niuyuling/Blueberry/HW/blueberry/BOM.xlsx

Device 设备名 | Name 名称 | Manufacturer Part 生产商编号 | Designator 标号 | Value 值 | Footprint 丝印 | Supplier Part (LCSC) 商城编号 | Quantity 数量 | 备注 Note | 确认
Allwinner_H616 | Allwinner H616 | Allwinner H616 | U5 | Allwinner H616 | BGA284P65B1200_1400H125 | N/A | 1 | Allwinner H616 | yes
H5TQ4G63EFR-RDC | DDR3/DDR3L DRAM | H5TQ4G63EFR-RDC | U2 | DDR3/DDR3L DRAM | FBGA96 | N/A | 1 | 可选择单 Rank 或双 Rank 的 DDR3、DDR3L 内存颗粒 | yes
AXP1530 | AXP313A | AXP313A | U1 | AXP313A | WQFN-20_L3.0-W3.0-P0.40-BL-EP | N/A | 1 | H616 的 配套PMIC | yes
B-2100S40P-B110 | B-2100S40P-B110 | B-2100S40P-B110 | H1 | B-2100S40P-B110 | HDR-TH_40P-P2.54-V-M-R2-C20-S2.54 | N/A | 1 | 40 Pin Raspberry Pi Connector，默认不焊接 | yes
EMMC BGA153 | THGBMJG7C1LBAIL | EMMC04G-M627-A01 | U4 | THGBMJG7C1LBAIL | FBGA-153_L13.0-W11.5 | C879825 | 1 | BGA153 eMMC, Up to 128GB | yes
RClamp0524PATCT | RClamp0524PATCT | RClamp0524PATCT | D19,D21 | RClamp0524PATCT | SLP2510P8_L2.5-W1.0-P0.50-BL | C40960 | 2 | ESD组件，测试可不贴 | yes
MLP2016S1R0MT0S1 | 1239AS-H-1R0M=P2 | 1239AS-H-1R0M=P2 | L1,L2,L3 | 1uH | IND-SMD_L2.5-W2.0 | C167447 | 3 | 1uH，1008封装电感，饱和 2.5A 以上 | yes 5个
HDMI-019S | HDMI-019S | HDMI-019S | HDMIOUT | HDMI-019S | HDMI-SMD_HDMI-019S | C111617 | 1 | HDMI 接口 | yes
1040310811 | 1040310811 | 1040310811 | SIM1 | 1040310811 | SIM-SMD_8P-1040310811 | C585350 | 1 | TF卡槽 | 没有
U.FL-R-SMT-1(80) | U.FL-R-SMT-1(80) | U.FL-R-SMT-1(80) | JP1 | U.FL-R-SMT-1(80) | RF-SMD_734120114 | C88374 | 1 | WIFI天线 | yes
533980271 | 0533980271 | 0533980271 | FAN1 | 533980271 | CONN-SMD_2P-P1.25_053398-0X71 | C122410 | 1 | 风扇接口 | yes 1个
RB521S-30 | RB521S-30 | RB521S-30 | D20 | RB521S-30 | SOD-523_L1.2-W0.8-LS1.6-FD | C122862 | 1 | 肖特基二极管 | yes
PJ-3930-8A | PJ-3930-8A | PJ-3930-8A | AUDIO1 | PJ-3930-8A | AUDIO-TH_PJ-3930-8A | C145811 | 1 | 3.5mm耳机座 | yes
Q22FA12800120 | 24M | Q22FA12800120 | X2 | 24M | OSC-SMD_4P-L2.0-W1.6-BL | C255879 | 1 | 无源晶振 | yes
Q22FA12800332 | 40M | Q22FA12800332 | X1 | 40M | OSC-SMD_4P-L2.0-W1.6-BL | C255899 | 1 | 无源晶振 | yes
B5819WS | B5819WS | B5819WS | D1,D22,D23 | B5819WS | SOD-323_L1.8-W1.3-LS2.5 | C248733 | 3 | 肖特基二极管 | yes
532610671 | 532610671 | 532610671 | CN1 | 532610671 | CONN-SMD_6P-P1.25_53261-0671 | C99277 | 1 | 线对板/线对线连接器 | yes
0402ESDA-05N | 0402ESDA-05N | 0402ESDA-05N | D2,D3,D4,D5,D6,D7,D8,D9,D10,D11,D12,D13,D14,D15,D16,D17,D18 | 0402ESDA-05N | D0402 | C316049 | 17 | 静电放电(ESD)保护器件 | yes
PTS810SJM250SMTRLFS | PTS810SJM250SMTRLFS | PTS810SJM250SMTRLFS | FEL,RESET | PTS810SJM250SMTRLFS | KEY-SMD_4P-L4.2-W3.2-P2.20-LS4.6_1 | C116501 | 2 | 轻触开关 | yes
TYPE-C-31-M-12 | TYPE-C-31-M-12 | TYPE-C-31-M-12 | USB1,USB2,USB3,USB4 | TYPE-C-31-M-12 | SMD | C165948 | 4 | USB TYPE-C | yes
0402WGF0000TCE | Res_0402 | 0402WGF0000TCE | R4,R5,R18,R32 | 0 | R0402 | C17168 | 4 |  | yes
0402WGF220JTCE | Res_0402 | 0402WGF220JTCE | R27,R29 | 22 | R0402 | C25092 | 2 |  | yes
0402WGF330JTCE | Res_0402 | 0402WGF330JTCE | R12,R13,R14 | 33 | R0402 | C25105 | 3 |  | yes
0402WGF750JTCE | Res_0402 | 0402WGF750JTCE | R30 | 75 | R0402 | C25133 | 1 |  | yes
0402WGF1000TCE | Res_0402 | 0402WGF1000TCE | R7,R38,R42,R45 | 100 | R0402 | C25076 | 4 |  | yes
RC0402FR-07240RL | Res_0402 | RC0402FR-07240RL | R6,R8,R9 | 240 | R0402 | C114755 | 3 | DRAM ZQ校准电阻，1%精度 | yes
0402WGF5100TCE | Res_0402 | 0402WGF5100TCE | R1,R28 | 510 | R0402 | C25123 | 2 |  | yes
0402WGF1001TCE | Res_0402 | 0402WGF1001TCE | R15,R34,R39 | 1K | R0402 | C11702 | 3 |  | yes
0402WGF2001TCE | Res_0402 | 0402WGF2001TCE | R10,R11 | 2K | R0402 | C4109 | 2 |  | yes
0402WGF5101TCE | Res_0402 | 0402WGF5101TCE | R35,R36,R40,R43,R44,R46,R48 | 5.1K | R0402 | C25905 | 7 |  | yes
RC-02W6041FT | Res_0402 | RC-02W6041FT | R26 | 6.04k | R0402 | C304624 | 1 | 内置PHY耦合电阻，1%精度 | yes
0402WGF1002TCE | Res_0402 | 0402WGF1002TCE | R2,R3,R41,R47,R49 | 10K | R0402 | C25744 | 5 |  | yes
0402WGF2702TCE | Res_0402 | 0402WGF2702TCE | R37 | 27K | R0402 | C25771 | 1 |  | yes
0402WGF4702TCE | Res_0402 | 0402WGF4702TCE | R33,R16,R17,R19,R20,R21,R22,R23,R24,R25,R50,R51,R52 | 47K | R0402 | C25792 | 10 |  | yes
RC0402FR-07150KL | Res_0402 | RC0402FR-07150KL | R31 | 150K | R0402 | C93947 | 1 |  | yes
0402CG220J500NT | CAP_0402 | 0402CG220J500NT | C80,C85,C94,C99 | 22pF | C0402 | C1555 | 4 |  | yes
CL05B104KO5NNNC | CAP_0402 | CL05B104KO5NNNC | C14,C15,C16,C17,C18,C19,C20,C21,C22,C23,C24,C25,C26,C27,C28,C29,C30,C31,C32,C33,C34,C35,C36,C37,C38,C39,C40,C41,C42,C43,C44,C45,C46,C47,C48,C49,C50,C51,C52,C53,C54,C55,C56,C57,C58,C59,C60,C61,C62,C63,C64,C65,C88,C90,C86,C87,C98,C100 | 100nF | C0402 | C1525 | 58 |  | yes
CL05B224KO5NNNC | CAP_0402 | CL05B224KO5NNNC | C97 | 220nF | C0402 | C16772 | 1 |  | yes
CL05A474KP5NNNC | CAP_0402 | CL05A474KP5NNNC | C92,C93 | 470nF | C0402 | C47339 | 2 |  | yes
CL05A105KA5NQNC | CAP_0402 | CL05A105KA5NQNC | C12,C68,C69,C70,C71,C72,C73,C74,C78,C79,C84,C96 | 1uF | C0402 | C52923 | 12 |  | yes
CL05A225MQ5NSNC | CAP_0402 | CL05A225MQ5NSNC | C75,C76,C77,C81,C82,C83,C95 | 2.2uF | C0402 | C12530 | 7 |  | yes
CL05A475MP5NRNC | CAP_0402 | CL05A475MP5NRNC | C1,C3,C5,C89,C91 | 4.7uF | C0402 | C23733 | 5 |  | yes
CL10A475KO8NNNC | CAP_0603 | CL10A475KO8NNNC | C2,C7,C10 | 4.7uF | C0603 | C19666 | 3 |  | yes
CL10A226MQ8NRNC | CAP_0603 | CL10A226MQ8NRNC | C4,C6,C8,C9,C11,C13 | 22uF | C0603 | C59461 | 6 |  | yes
RTL8189ES-VB-CG |  | RTL8189ES-VB-CG | U5 |  | QFN-32_L5.0-W5.0-P0.50-TL-EP3.5 | C2691978 | 1 | 无线收发芯片 | yes
GRM0335C1H1R0WA01D |  | GRM0335C1H1R0WA01D | C110,C113,C114,C115 | 1pF | C0201 | C161411 | 4 |  | yes
CL03A104KO3NNNC |  | CL03A104KO3NNNC | C66,C67,C68,C69,C70,C71,C104,C105,C106,C107,C108,C117,C120 | 100nF | C0201 | C307380 | 13 |  | yes
0201CG1R2B500NT |  | 0201CG1R2B500NT | C112,C119 | 1.2pF | C0201 | C285029 | 2 |  | yes
0201CG7R0C250NT |  | 0201CG7R0C250NT | C109,C123 | 7pF | C0201 | C285008 | 2 |  | yes
GRM035R60J475ME15D |  | GRM035R60J475ME15D | C116,C124 | 4.7uF | C0201 | C335103 | 2 |  | yes
CL05A106MP5NUNC |  | CL05A106MP5NUNC | C118 | 10uF | C0402 | C315248 | 1 |  | yes
0201CG101J500NT |  | 0201CG101J500NT | C102 | 100pF | C0201 | C62550 | 1 |  | yes
CC0201JRNPO9BN220 |  | CC0201JRNPO9BN220 | C121,C122 | 22pF | C0201 | C272881 | 2 |  | yes
LQP03TN10NH02D |  | LQP03TN10NH02D | L4,L5 | 10nH | L0201 | C162594 | 2 |  | yes
SDCL0603Q2N7BT02B03 |  | SDCL0603Q2N7BT02B03 | L6,L7,L8 | 2.7nH | L0201-RD | C279775 | 3 |  | yes
MLZ1005N4R7LTD25 |  | MLZ1005N4R7LTD25 | L9 | 4.7uH | L0402 | C404795 | 1 |  | yes
RC0402FR-0710KL |  | RC0402FR-0710KL | R56 | 10kΩ | R0402 | C60490 | 1 |  | yes
0402WGF0000TCE |  | 0402WGF0000TCE | R55,R57 | 0Ω | R0402 | C17168 | 2 |  | yes
RC0402FR-07100KL |  | RC0402FR-07100KL | R54 | 100kΩ | R0402 | C60491 | 1 |  | yes
0603WAF1004T5E |  | 0603WAF1004T5E | R53 | 1MΩ | R0603 | C22935 | 1 |  | yes
