niuyuling/Blueberry/HW/blueberry/SCH_blueberry_2023-11-09.pdf

GND56 V21 GND55 V19 GND54 V12 GND53 V5 GND52 V1 GND51 U13 GND50 U6 GND49 T17 GND48 T15 GND47 T10 GND46 T8 GND45 T3 GND44 T1 GND43 R21 GND42 R5 GND41 P3 GND40 N18 GND39 N15 GND38 N12 GND37 N9 GND36 N6 GND35 M3 GND34 M2 GND33 L21 GND32 K15 GND31 K14 GND30 K13 GND29 K12 GND28 K11 GND27 K10 GND26 K9 GND25 K8 GND24 M1 GND23 J15 GND22 J14 GND21 J13 GND20 J12 GND19 H19 GND18 H15 GND17 H14 GND16 H13

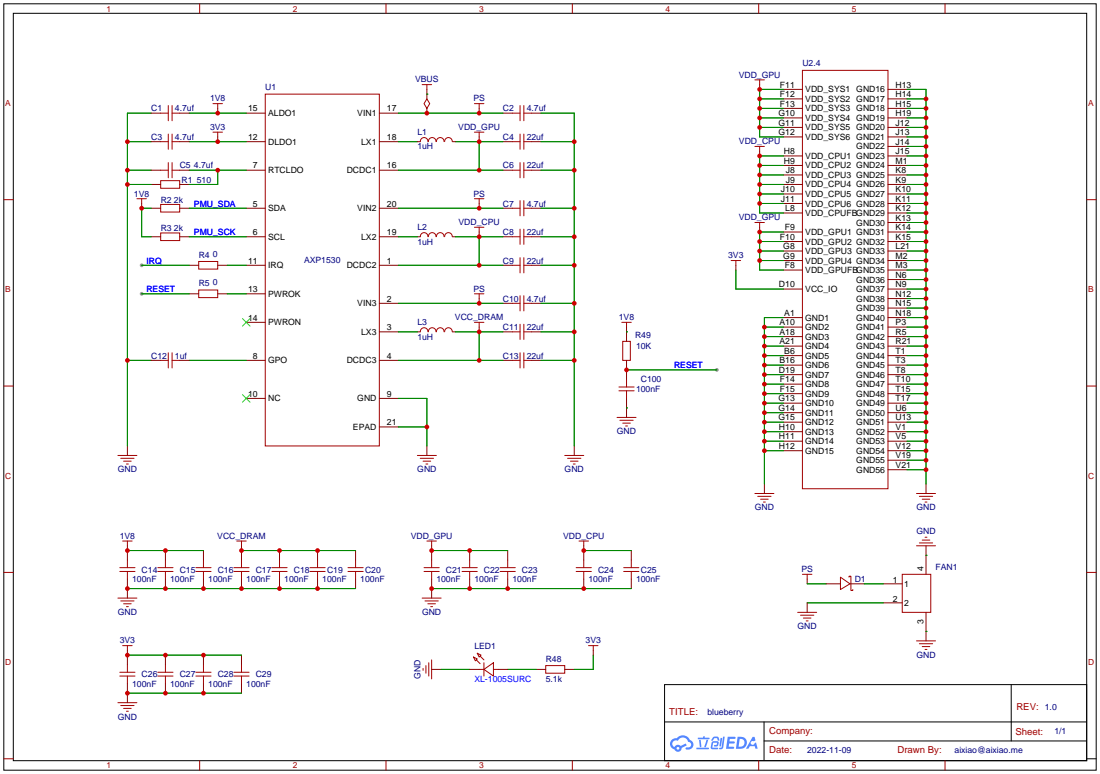
[picture p9: page 1]

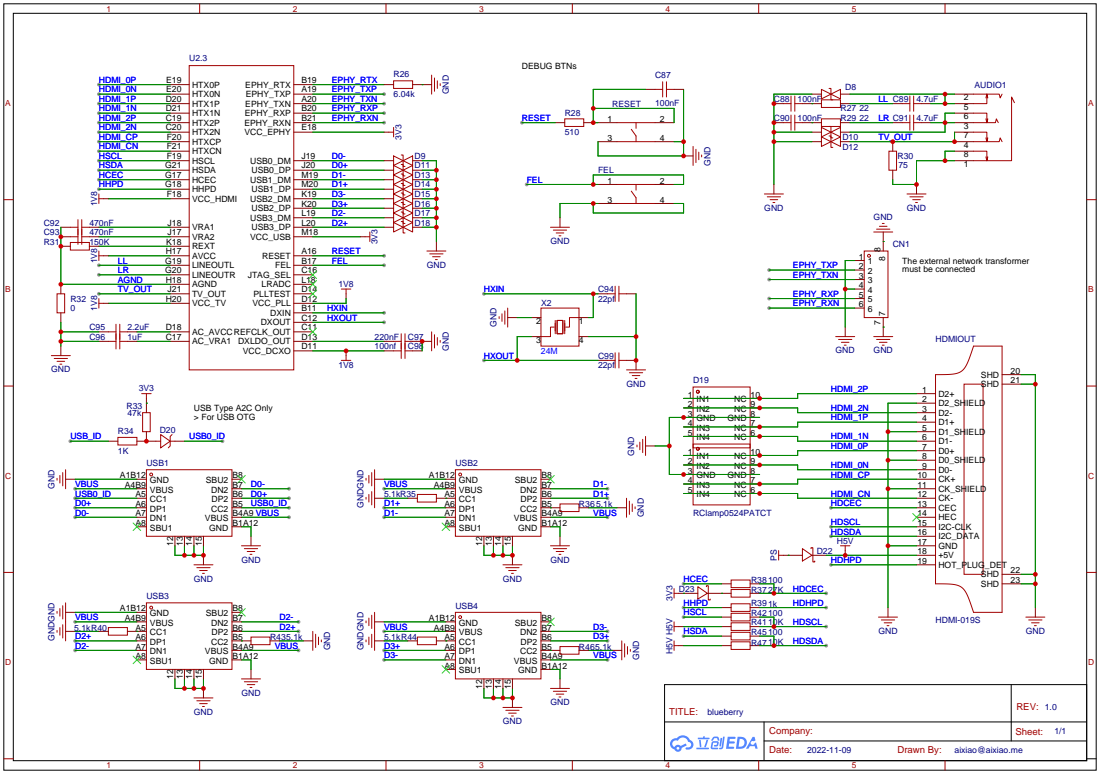
[picture p10: page 2]

VCC_HDMI F18 HHPD G18 HCEC G17 HSDA G21 HSCL F19 HTXCN F21 HTXCP F20 HTX2N C20 HTX2P C19 HTX1N D21 HTX1P D20 HTX0N E20 HTX0P E19

VCC_TV H20 TV_OUT J21 AGND H18 LINEOUTR G20 LINEOUTL G19 AVCC H17 REXT K18 VRA2 J17 VRA1 J18

VCC_DCXO D11 DXLDO_OUT D13 REFCLK_OUT C11 DXOUT C12 DXIN B11 VCC_PLL D12 PLLTEST D14 LRADC L18 JTAG_SEL C16 FEL B17 RESET A16

The external network transformer
must be connected

VDD18_DRAM L14 VCC_DRAM5 L13 VCC_DRAM4 L12 VCC_DRAM3 L11 VCC_DRAM2 L10 VCC_DRAM1 L9 SZQ L15 SDQ31 R12 SDQ30 P12 SDQ29 U11 SDQ28 P10 SDQ27 P9 SDQ26 N7 SDQ25 P7 SDQ24 R9 SDQ23 T5 SDQ22 T7 SDQ21 U5 SDQ20 T6 SDQ19 U9 SDQ18 T12 SDQ17 U12 SDQ16 T11 SDQ15 N5 SDQ14 P6 SDQ13 N4 SDQ12 R6 SDQ11 R4 SDQ10 P4 SDQ9 V3 SDQ8 P5 SDQ7 P2 SDQ6 T2 SDQ5 P1 SDQ4 U3 SDQ3 T4 SDQ2 N2 SDQ1 U4 SDQ0 N3

SDQM3 N10 SDQM2 T9 SDQM1 R3 SDQM0 U1 SDQS3N U10 SDQS3P V10 SDQS2N U8 SDQS2P V8 SDQS1N V2 SDQS1P U2 SDQS0N R1 SDQS0P R2 SRST U21 SCKE1 P13 SCKE0 V15 SCKN U14 SCKP T14 SODT1 N20 SODT0 T20 SCS1 R20 SCS0 V17 SACT P18 SBG1 P21 SBG0 P20 SBA1 R15 SBA0 N21 SA16 U18 SA15 N13 SA14 V20 SA13 P16 SA12 U16 SA11 U15 SA10 R19 SA9 N16 SA8 U19 SA7 N19 SA6 U20 SA5 P15 SA4 R18 SA3 T16 SA2 T18 SA1 U17 SA0 T21

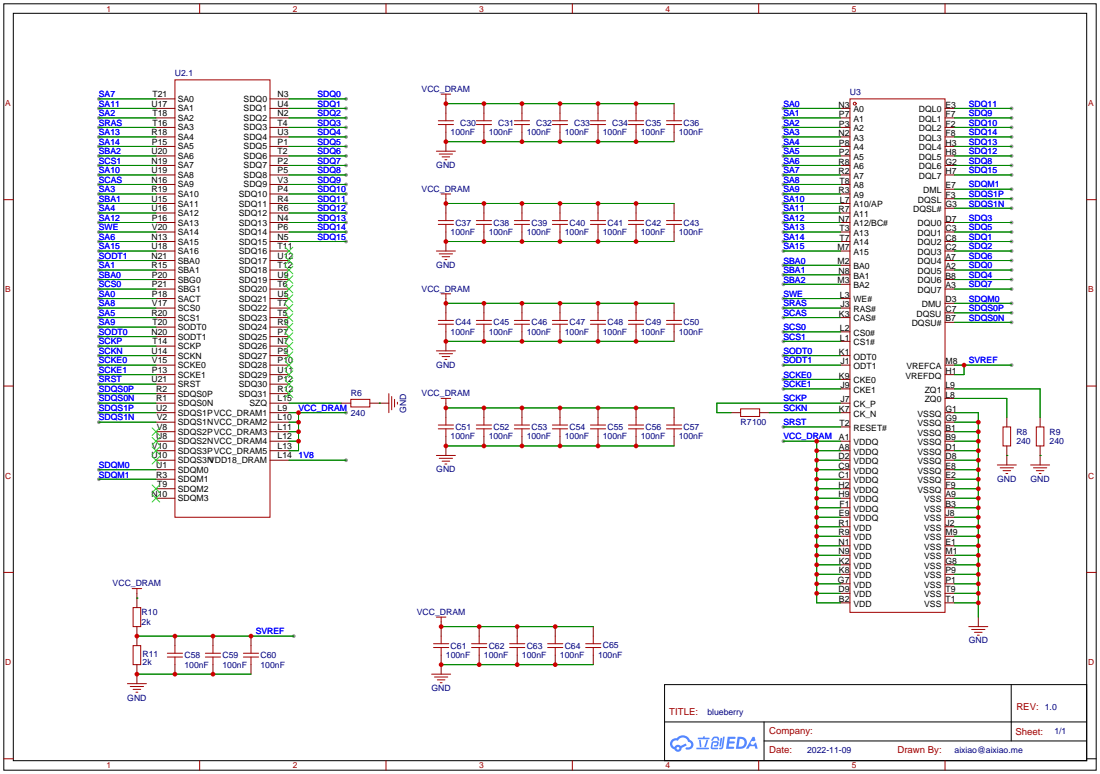
[picture p11: page 3]

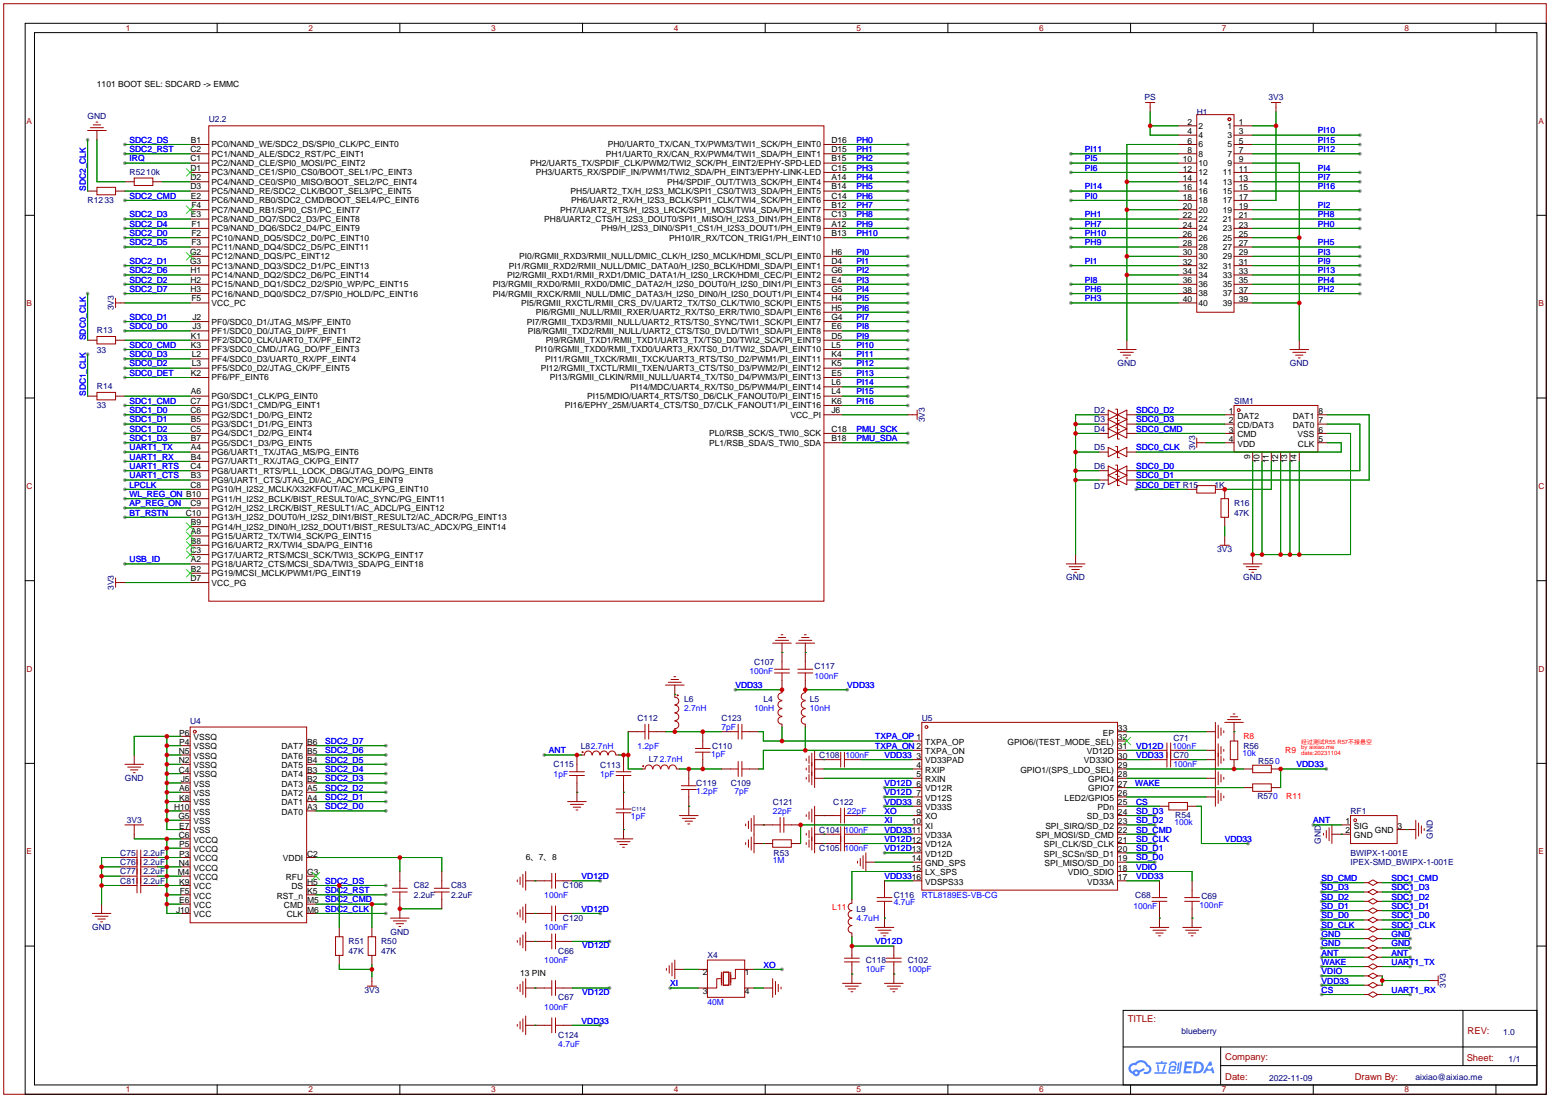
[picture p12: page 4]

1101 BOOT SEL: SDCARD -> EMMC

PH10/IR_RX/TCON_TRIG1/PH_EINT10 B13 PH9/H_I2S3_DIN0/SPI1_CS1/H_I2S3_DOUT1/PH_EINT9 A12 PH8/UART2_CTS/H_I2S3_DOUT0/SPI1_MISO/H_I2S3_DIN1/PH_EINT8 C13 PH7/UART2_RTS/H_I2S3_LRCK/SPI1_MOSI/TWI4_SDA/PH_EINT7 B12 PH6/UART2_RX/H_I2S3_BCLK/SPI1_CLK/TWI4_SCK/PH_EINT6 C14 PH5/UART2_TX/H_I2S3_MCLK/SPI1_CS0/TWI3_SDA/PH_EINT5 B14 PH4/SPDIF_OUT/TWI3_SCK/PH_EINT4 A14 PH3/UART5_RX/SPDIF_IN/PWM1/TWI2_SDA/PH_EINT3/EPHY-LINK-LED C15 PH2/UART5_TX/SPDIF_CLK/PWM2/TWI2_SCK/PH_EINT2/EPHY-SPD-LED B15 PH1/UART0_RX/CAN_RX/PWM4/TWI1_SDA/PH_EINT1 D15 PH0/UART0_TX/CAN_TX/PWM3/TWI1_SCK/PH_EINT0 D16

VDDI C2
CLK M6 CMD M5 RST_n K5 DS H5 RFU G3
