niuyuling/Blueberry/HW/RTL8189ES_STAMP_Module-1V0.pdf

## WIFI_SD_CLK

## WIFI_SD_CMD

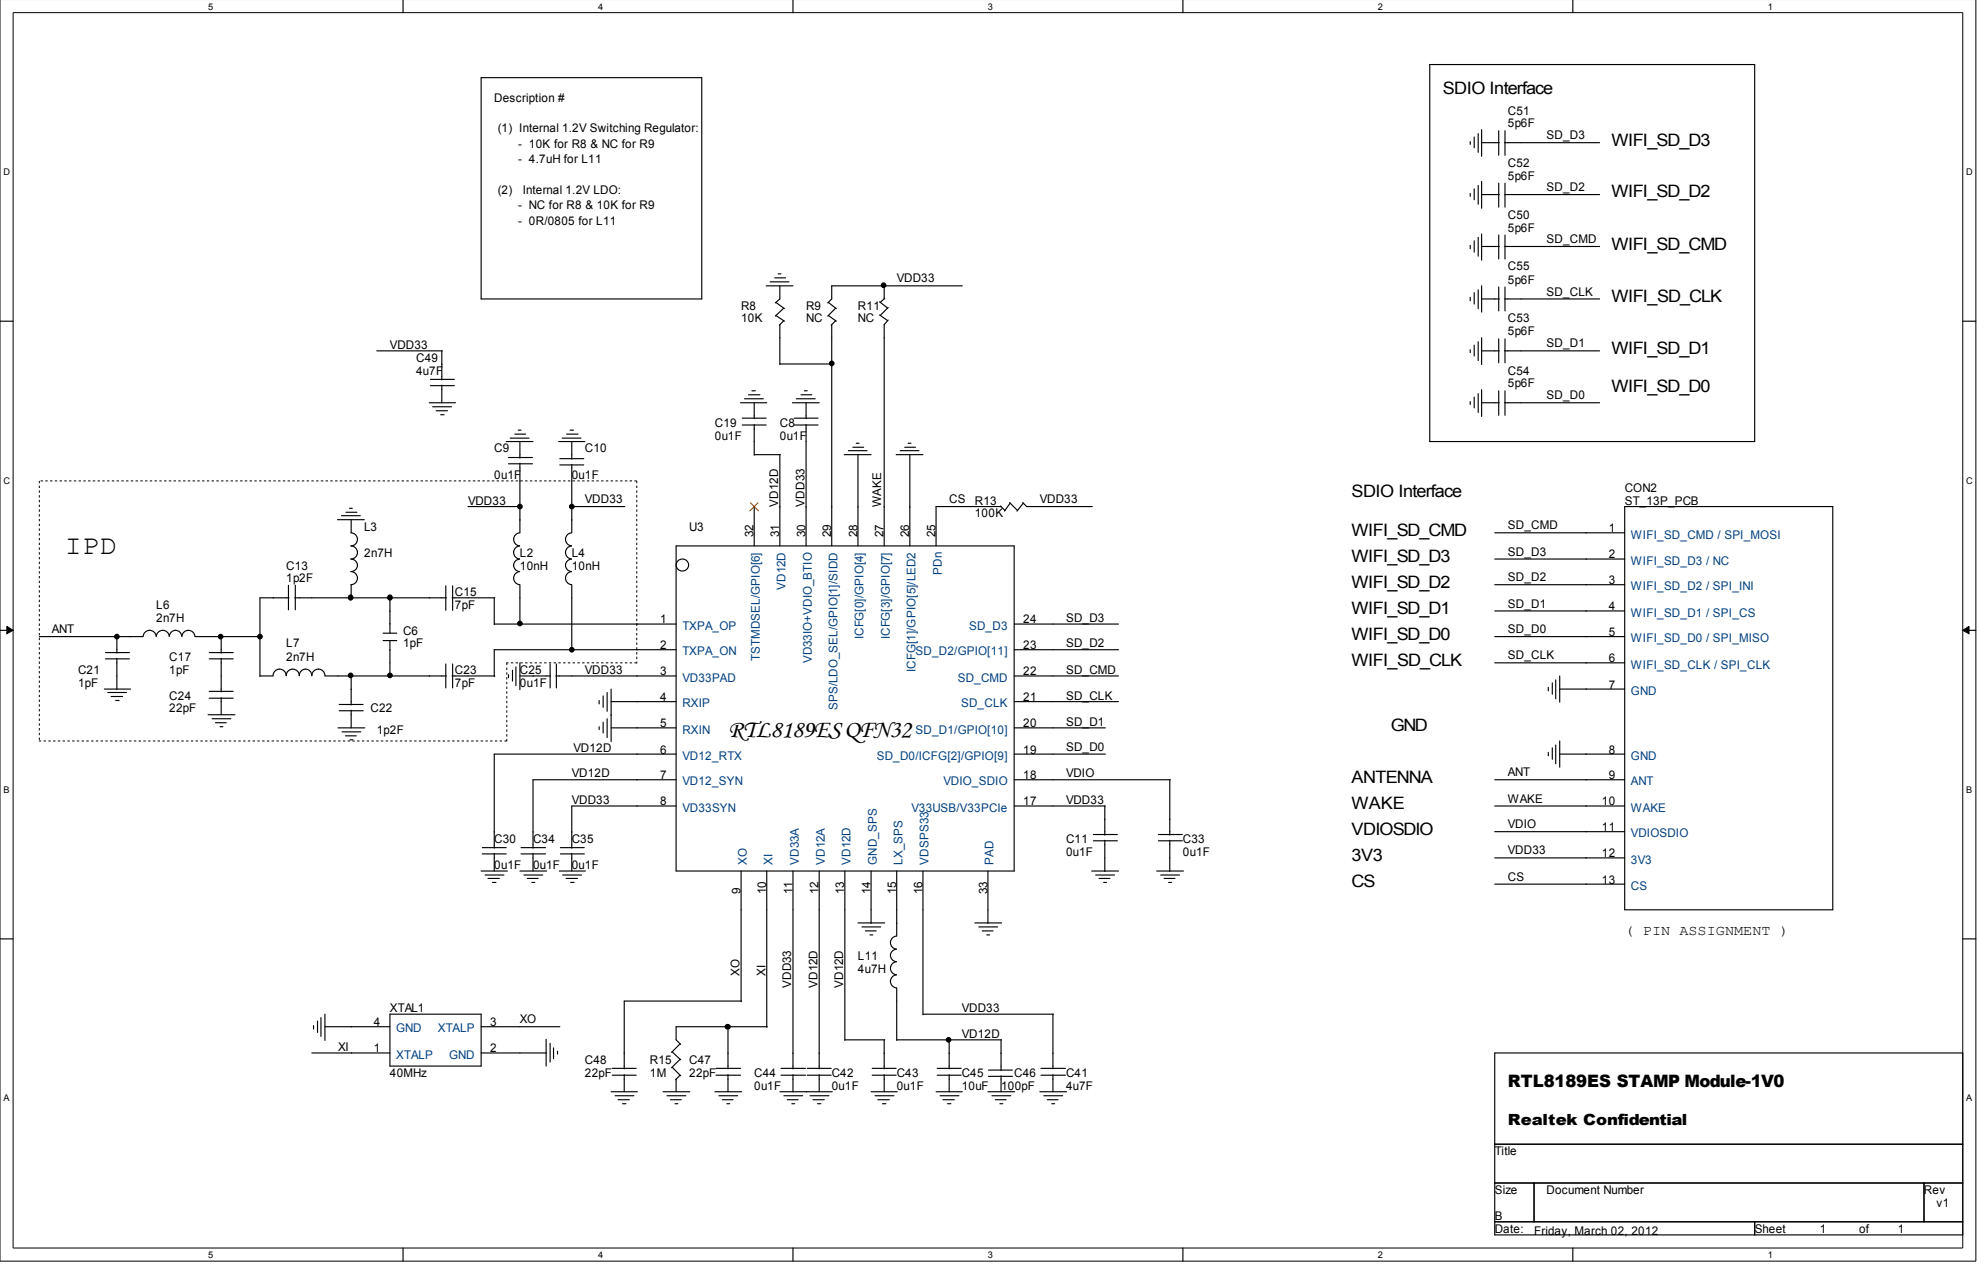
[picture p13: page 1]

Size B | Document Number | Rev v1

Date: Friday, March 02, 2012 | Sheet 1 of 1
