niuyuling/Blueberry/HW/rj45/SCH_RJ45_2023-11-09.pdf

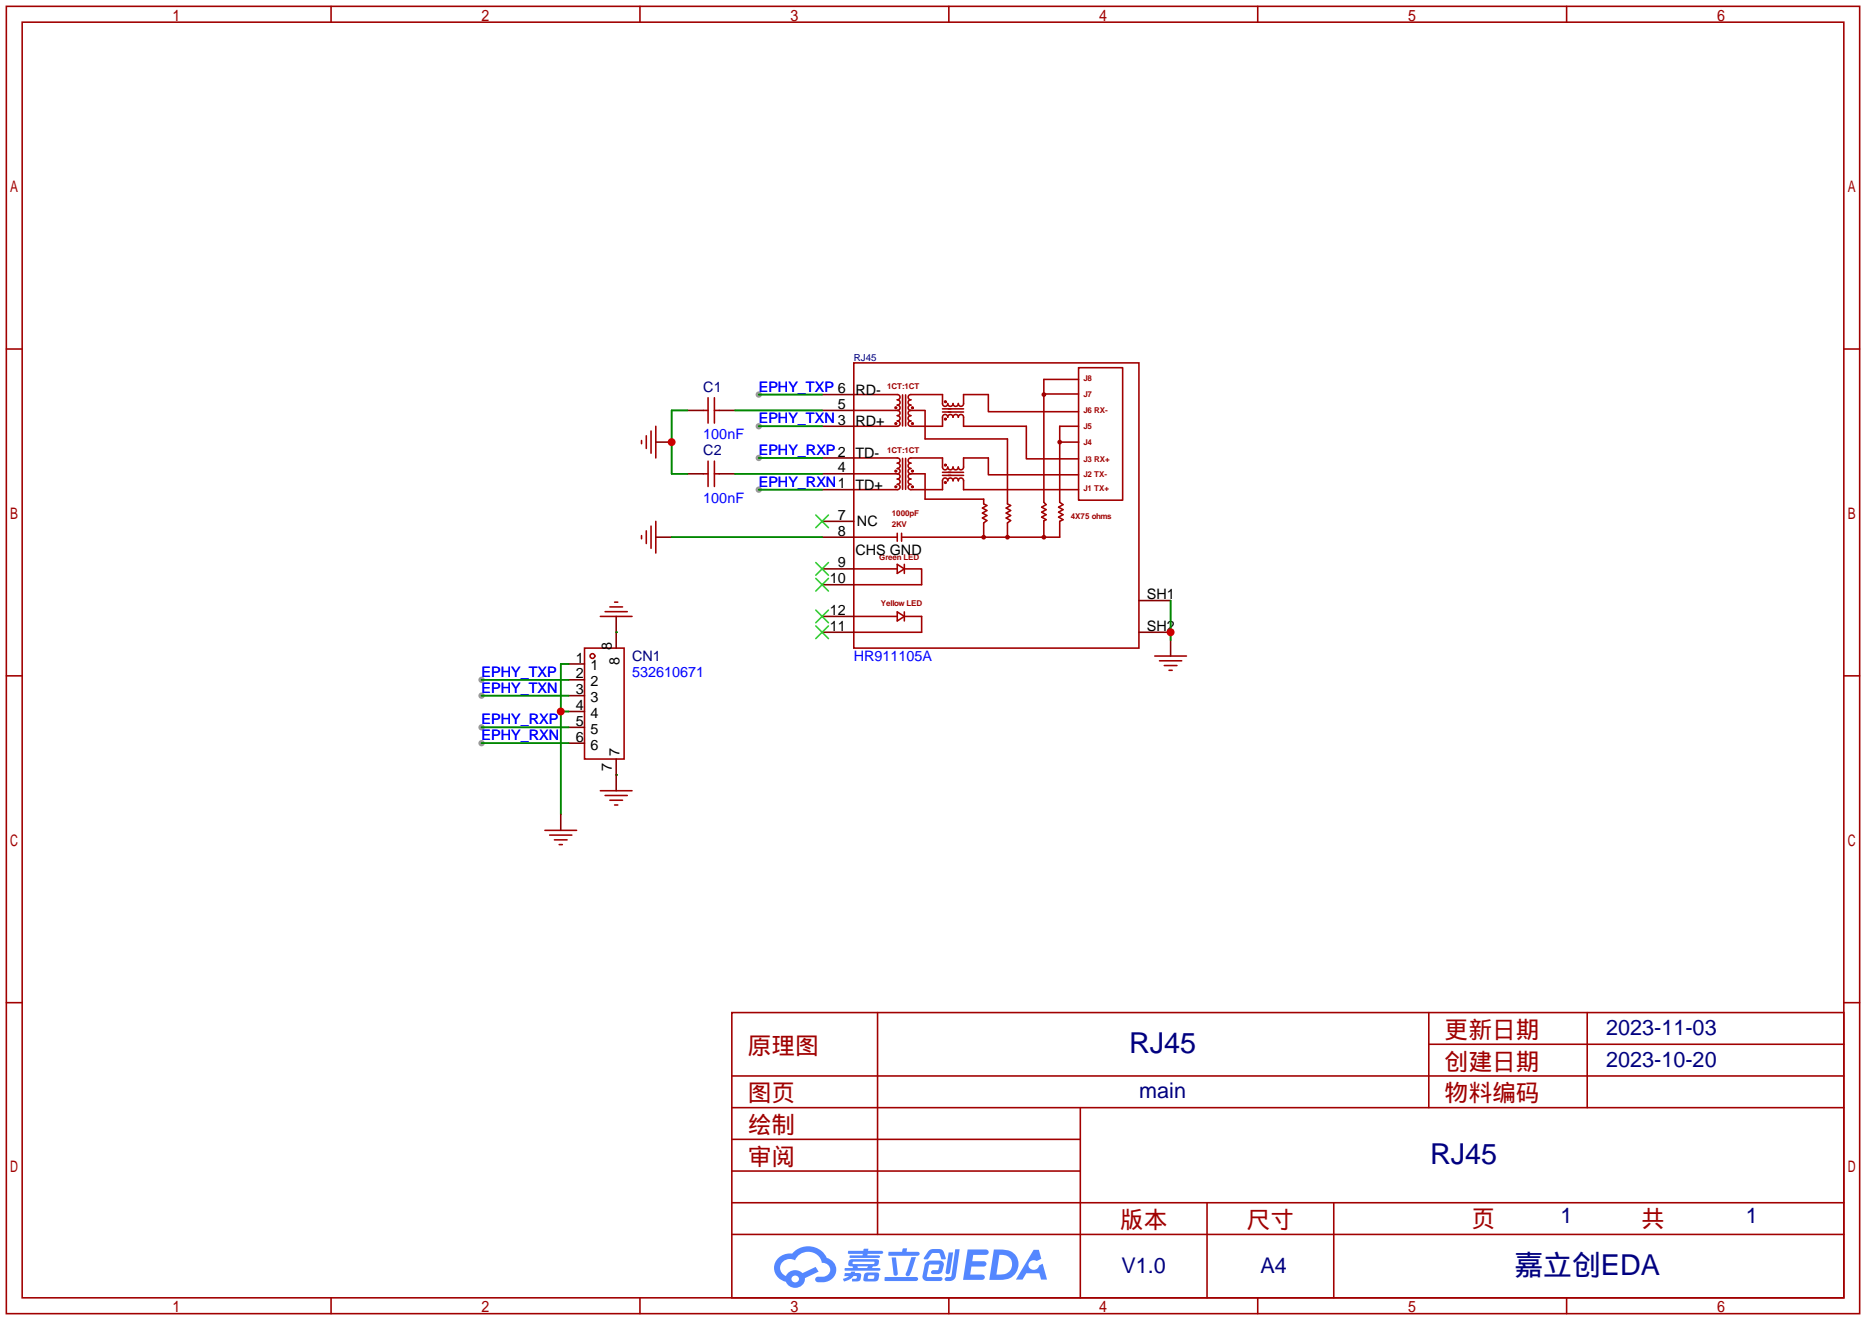
[picture p14: page 1]
