niuyuling/Blueberry/(list of files, drawings)

Other design files:
HW/blueberry/ProProject_blueberry_2023-11-09.epro
HW/rj45/ProProject_RJ45_2023-11-09.epro
